wyolum/ArthurC/README.md

ArthurC
=======

rev 2 of i2GPS - called ArthurC in honor of Arthur C Clarke, who coined the idea of GPS
