wyolum/ArthurC/KiCAD/rev2/arthurc_BoM.ods

Sheet: BoM
BoM, for kit building assembly
ref | value | Vendor | Vendor P/N | NOTE 2 | QTY | RATE | AMOUNT
BT1 | BATT_RTC | DigiKey (http://search.digikey.com/us/en/products/BHX1-1632-SM/BHX1-1632-SM-ND/2194759) | BHX1-1632-SM-ND | SMD Battery socket for CR1632 | 1 | 0.44 | 0.44
* | CR1632 | DigiKey (http://search.digikey.com/us/en/products/CR1632/P036-ND/269743) | P036-ND | Battery, CR1632 | 1 | 1.08 | 1.08
C1 | 100n | DigiKey (http://search.digikey.com/us/en/products/GRM216F51C104ZA01D/490-1734-1-ND/587608) | 490-1734-1-ND | Decoupling Capacitor | 1 | 0.05 | 0.05
C2 | 1u | DigiKey (http://search.digikey.com/us/en/products/C2012Y5V1C105Z/0.85/0.85/445-1589-1-ND/603224) | 445-1589-1-ND | Non-electrolytic (Ceramic) | 1 | 0.06 | 0.06
C3 | 2u2 | DigiKey (http://search.digikey.com/us/en/products/F921A225MPA/493-2331-1-ND/677799) | 493-2331-1-ND | Tantalum, Polarized, 10V | 1 | 0.46 | 0.46
C4 | 100n | DigiKey (http://search.digikey.com/us/en/products/GRM216F51C104ZA01D/490-1734-1-ND/587608) | 490-1734-1-ND | Decoupling Capacitor | 1 | 0.05 | 0.05
C5 | 1u | DigiKey (http://search.digikey.com/us/en/products/C2012Y5V1C105Z/0.85/445-1589-1-ND/603224) | 445-1589-1-ND | Non-electrolytic (Ceramic) | 1 | 0.06 | 0.06
C6 | 47u | DigiKey (http://search.digikey.com/us/en/products/EEE-1AA470WR/PCE3875CT-ND/766251) | PCE3875CT-ND | Electrolytic, SMD | 1 | 0.43 | 0.43
C7 | 100n | DigiKey (http://search.digikey.com/us/en/products/GRM216F51C104ZA01D/490-1734-1-ND/587608) | 490-1734-1-ND | Decoupling Capacitor | 1 | 0.05 | 0.05
C8 | 100n | DigiKey (http://search.digikey.com/us/en/products/GRM216F51C104ZA01D/490-1734-1-ND/587608) | 490-1734-1-ND | Decoupling Capacitor | 1 | 0.05 | 0.05
C9 | 100n | DigiKey (http://search.digikey.com/us/en/products/GRM216F51C104ZA01D/490-1734-1-ND/587608) | 490-1734-1-ND | Decoupling Capacitor | 1 | 0.05 | 0.05
C10 | 22p | DigiKey (http://www.digikey.com/product-detail/en/C0805C220J5GACTU/399-1113-1-ND/411388) | 399-1113-1-ND |  | 1 | 0.05 | 0.05
C11 | 22p | DigiKey (http://www.digikey.com/product-detail/en/C0805C220J5GACTU/399-1113-1-ND/411388) | 399-1113-1-ND |  | 1 | 0.05 | 0.05
D1 | LED | DigiKey (http://search.digikey.com/us/en/products/LG%20M67K-H1J2-24-Z/475-2730-1-ND/1938897) | 475-2730-1-ND | LED, Green, 2mA current | 1 | 0.19 | 0.19
D2 | LED | DigiKey (http://search.digikey.com/us/en/products/LG%20M67K-H1J2-24-Z/475-2730-1-ND/1938897) | 475-2730-1-ND | LED, Green, 2mA current | 1 | 0.19 | 0.19
D3 | RB886GT2R | DigiKey (http://search.digikey.com/us/en/products/RB886GT2R/RB886GT2RCT-ND/2425047) | RB886GT2RCT-ND | Schottky Diode, Vf=0.35V | 1 | 0.46 | 0.46
D4 | RB886GT2R | DigiKey (http://search.digikey.com/us/en/products/RB886GT2R/RB886GT2RCT-ND/2425047) | RB886GT2RCT-ND | Schottky Diode, Vf=0.35V | 1 | 0.46 | 0.46
IC1 | ATMEGA328 | Mouser (http://cn.mouser.com/ProductDetail/Atmel/ATMEGA328P-AU/?qs=K8BHR703ZXjB9uTYboq2G8tTH4sPZjy6RRxLXuJxae0=) | 556-ATMEGA328P-AU | Micro-controller | 1 | 2.41 | 2.41
PCB1 | PCB | seeed | PCB, 2.5” x 1.2” | PCB | 1 | 0.00 | 0.00
R1 | 10k | DigiKey (http://search.digikey.com/us/en/products/RR1220P-103-D/RR12P10.0KDCT-ND/432854) | RR12P10.0KDCT-ND |  | 1 | 0.11 | 0.11
R2 | 10k | DigiKey (http://search.digikey.com/us/en/products/RR1220P-103-D/RR12P10.0KDCT-ND/432854) | RR12P10.0KDCT-ND |  | 1 | 0.11 | 0.11
R3 | 10k | DigiKey (http://search.digikey.com/us/en/products/RR1220P-103-D/RR12P10.0KDCT-ND/432854) | RR12P10.0KDCT-ND |  | 1 | 0.11 | 0.11
R4 | 10k | DigiKey (http://search.digikey.com/us/en/products/RR1220P-103-D/RR12P10.0KDCT-ND/432854) | RR12P10.0KDCT-ND |  | 1 | 0.11 | 0.11
R5 | 1k5 | DigiKey (http://search.digikey.com/us/en/products/RR1220P-152-D/RR12P1.5KDCT-ND/432834) | RR12P1.5KDCT-ND |  | 1 | 0.11 | 0.11
R6 | 10k | DigiKey (http://search.digikey.com/us/en/products/RR1220P-103-D/RR12P10.0KDCT-ND/432854) | RR12P10.0KDCT-ND |  | 1 | 0.11 | 0.11
R7 | 10k | DigiKey (http://search.digikey.com/us/en/products/RR1220P-103-D/RR12P10.0KDCT-ND/432854) | RR12P10.0KDCT-ND |  | 1 | 0.11 | 0.11
R8 | 1k5 | DigiKey (http://search.digikey.com/us/en/products/RR1220P-152-D/RR12P1.5KDCT-ND/432834) | RR12P1.5KDCT-ND |  | 1 | 0.11 | 0.11
R9 | 10k | DigiKey (http://search.digikey.com/us/en/products/RR1220P-103-D/RR12P10.0KDCT-ND/432854) | RR12P10.0KDCT-ND |  | 1 | 0.11 | 0.11
SD1 | SD_CARD_MICRO | DigiKey (http://search.digikey.com/us/en/products/101-00434-68/101-00434-68-1-ND/2187103) | 101-00434-68-1-ND | CONN SIM+MICRO-SD 14PIN PCB GOLD | 1 | 3.06 | 3.06
SW1 | SW_PUSH | DigiKey (http://search.digikey.com/us/en/products/EVQ-P2602W/P12301SCT-ND/593601) | P12301SCT-ND | Reset Switch | 1 | 0.83 | 0.83
U1 | 3V3 | DigiKey (http://goo.gl/aD8x4) | MCP1700T3302ETTCT-ND | 3.3V Regulator, MCP1700T-3302E/TT | 1 | 0.45 | 0.45
U2 | 74HC125 | DigiKey (http://search.digikey.com/us/en/products/MC74HC125ADG/MC74HC125ADGOS-ND/1479839) | MC74HC125ADGOS-ND | Alternative P/N – 296-1192-1-ND | 1 | 0.44 | 0.44
U3 | 5V0 | DigiKey (http://search.digikey.com/us/en/products/MIC5219-5.0YM5%20TR/576-2770-1-ND/1821930) | 576-2770-1-ND | 5.0V Regulator, MIC5219-5.0BM5 | 1 | 1.43 | 1.43
U4 | DS3231N | DigiKey (http://goo.gl/gg9GS) | DS3231S#-ND | RTC | 1 | 7.94 | 7.94
X1 | CRYSTAL_2 | DigiKey (http://search.digikey.com/us/en/products/CX3225GB16000D0HEQZ1/478-6622-1-ND/2665884) | 478-6622-1-ND | 16MHz Crystal, SMD | 1 | 1.30 | 1.30
 |  |  |  |  | 35 | 23.00 | 23.00
NOT USED COMPONENTS
B1 | I/O |  |  | break out pads | 1 | 0.00 | 0.00
B2 | I/O |  |  | break out pads | 1 | 0.00 | 0.00
B3 | I/O |  |  | break out pads | 1 | 0.00 | 0.00
B4 | I/O |  |  | break out pads | 1 | 0.00 | 0.00
B5 | I/O |  |  | break out pads | 1 | 0.00 | 0.00
B6 | I/O |  |  | break out pads | 1 | 0.00 | 0.00
B7 | I/O |  |  | break out pads | 1 | 0.00 | 0.00
B8 | I/O |  |  | break out pads | 1 | 0.00 | 0.00
B9 | I/O |  |  | break out pads | 1 | 0.00 | 0.00
B10 | I/O |  |  | break out pads | 1 | 0.00 | 0.00
B11 | I/O |  |  | break out pads | 1 | 0.00 | 0.00
B12 | I/O |  |  | break out pads | 1 | 0.00 | 0.00
B13 | I/O |  |  | break out pads | 1 | 0.00 | 0.00
B14 | I/O |  |  | break out pads | 1 | 0.00 | 0.00
B15 | I/O |  |  | break out pads | 1 | 0.00 | 0.00
B16 | I/O |  |  | break out pads | 1 | 0.00 | 0.00
B17 | I/O |  |  | break out pads | 1 | 0.00 | 0.00
B18 | I/O |  |  | break out pads | 1 | 0.00 | 0.00
B19 | I/O |  |  | break out pads | 1 | 0.00 | 0.00
P1 | I/O |  |  | break out pads | 1 | 0.00 | 0.00
P3 | BootDrive | DigiKey (http://search.digikey.com/us/en/products/68000-236HLF/609-3465-ND/2023290) | 475-2555-1-ND | Header for BootDrive | 1 | 0.18 | 0.18
P4 | CONN_6 | DigiKey (http://search.digikey.com/us/en/products/68000-236HLF/609-3465-ND/2023290) | 475-2555-1-ND | Buckler Interface | 1 | 0.18 | 0.18
P5 | CONN_6 | DigiKey (http://search.digikey.com/us/en/products/68000-236HLF/609-3465-ND/2023290) | 475-2555-1-ND | Buckler Interface | 1 | 0.18 | 0.18
P6 | CONN_2 | DigiKey (http://search.digikey.com/us/en/products/68000-236HLF/609-3465-ND/2023290) | 475-2555-1-ND | Ext. 9V Battery | 1 | 0.06 | 0.06
P7 | GPS_UP501 | DigiKey (http://search.digikey.com/us/en/products/68000-236HLF/609-3465-ND/2023290) | 475-2555-1-ND | GPS Header | 1 | 0.18 | 0.18
P8 | FTDI | DigiKey (http://search.digikey.com/us/en/products/68000-236HLF/609-3465-ND/2023290) | 475-2555-1-ND | FTDI <>USB Interface | 1 | 0.18 | 0.18
P9 | ISP | DigiKey (http://search.digikey.com/us/en/products/67996-130HLF/609-3456-ND/2023300) | 609-3456-ND | ISP Programming Interface | 1 | 0.37 | 0.37
P10 | CD2 | DigiKey (http://search.digikey.com/scripts/DkSearch/dksus.dll?vendor=0&keywords=S5635-ND) | S5635-ND | ChronoDot/rtcBoB connections | 1 | 0.92 | 0.92
P11 | CD2 | DigiKey (http://search.digikey.com/scripts/DkSearch/dksus.dll?vendor=0&keywords=S5635-ND) | S5635-ND | either P10+P12 or P11+P13 | 1 | 0.92 | 0.92
P12 | CD1 | DigiKey (http://search.digikey.com/scripts/DkSearch/dksus.dll?vendor=0&keywords=S5635-ND) | S5635-ND | ChronoDot/rtcBoB connections | 1 | 0.92 | 0.92
P13 | CD1 | DigiKey (http://search.digikey.com/scripts/DkSearch/dksus.dll?vendor=0&keywords=S5635-ND) | S5635-ND | either P10+P12 or P11+P13 | 1 | 0.92 | 0.92
SC1 | SCREW |  |  | Mounting Hole | 1 | 0.00 | 0.00
 |  |  |  |  | 32 | 4.98 | 4.98
MISC. COMPONENTS
 | SD_CARD |  | http://www.te.com/catalog/bin/TE.Connect?C=1&M=BYPN&TCPN=2041021-3&RQPN=2041021-3
 | 35R2925 |  | http://www.newark.com/te-connectivity/2041021-3/memory-card-connector-sd-9pos/dp/35R2925?CMP=AFC-HEARST
 | A101492CT-ND |  | http://search.digikey.com/scripts/DkSearch/dksus.dll?Detail&name=A101492CT-ND
 |  |  |  |  | 0 | 0.00 | 0.00
 |  |  |  |  |  |  | 23.00

Sheet: BoM_PCB
Id | Designator | Package | Quantity | Designation | Supplier and ref
1 | B1,B2,B3,B4,B5,B6,B7,B8,B9,B12,B13,B14,B15,B18,B19,P1, | I/O | 16 | I/O
2 | B10,B11,B16,B17 | I/O_ADR | 4 | I/O
3 | BT1 | CR1632 | 1 | BATT_RTC
4 | C1,C4,C7,C8,C9 | c_0805 | 5 | 100n
5 | C10,C11 | c_0805 | 2 | 22p
6 | C2,C5 | c_0805 | 2 | 1u
7 | C3 | c_0805 | 1 | 2u2_Tant
8 | C6 | C_ELCO_SMD | 1 | 47u,10V
9 | D1,D2 | d_0805 | 2 | LED
10 | D3,D4 | d_VMD2 | 2 | RB886GT2R
11 | G*** | OSHW_6mm | 1 | LOGO
12 | G1,G1 | Logo-WL3 | 2 | Logo-WL3
13 | IC1 | TQFP32 | 1 | ATMEGA328
14 | P10,P11 | Sck-04-F-SMT | 2 | CD2
15 | P12,P13 | Sck-04-F-SMT | 2 | CD1
16 | P3 | PIN_ARRAY-6X1 | 1 | BootDrive
17 | P4,P5 | PIN_ARRAY-6X1 | 2 | CONN_6
18 | P6 | pin_strip_2 | 1 | CONN_2
19 | P7 | PIN_ARRAY-6X1 | 1 | GPS_UP501
20 | P8 | PIN_ARRAY-6X1 | 1 | FTDI
21 | P9 | ISP | 1 | ISP
22 | PCB1 | PCB | 1 | PCB
23 | R1,R2,R3,R4,R6,R7,R9 | r_0805 | 7 | 10k
24 | R5,R8 | r_0805 | 2 | 1k5
25 | SC1 | vite_3mm | 1 | SCREW
26 | SD1 | SD_Micro | 1 | SD_CARD_MICRO
27 | SW1 | SW_SMD | 1 | SW_PUSH
28 | U1 | SOT23-3 | 1 | 3V3
29 | U2 | SO14E | 1 | 74HC125
30 | U3 | SOT23-5 | 1 | 5V0
31 | U4 | DS3231 | 1 | DS3231N
32 | X1 | Xtal_SMD2 | 1 | CRYSTAL_2
 |  |  | 69

Sheet: BoM_SCH
ref | value | footprint | Field1 | Field2 | Field3 | Field4 | Field5 | Field6 | Field7 | Field8
B1 | I/O | I/O
B2 | I/O | I/O
B3 | I/O | I/O
B4 | I/O | I/O
B5 | I/O | I/O
B6 | I/O | I/O
B7 | I/O | I/O
B8 | I/O | I/O
B9 | I/O | I/O
B10 | I/O | I/O_ADR
B11 | I/O | I/O_ADR
B12 | I/O | I/O
B13 | I/O | I/O
B14 | I/O | I/O
B15 | I/O | I/O
B16 | I/O | I/O_ADR
B17 | I/O | I/O_ADR
B18 | I/O | I/O
B19 | I/O | I/O
BT1 | BATT_RTC | CR1632 | BU2032SM-HD-GCT-ND |  |  |  |  |  |  |  | BU2032SM-HD-GCT-ND
C1 | 100n | c_0805
C2 | 1u | c_0805
C3 | 2u2 | Tant | c_0805 |  |  |  |  |  |  |  | c_0805
C4 | 100n | c_0805
C5 | 1u | c_0805
C6 | 47u | 10V | C_ELCO_SMD |  |  |  |  |  |  |  | C_ELCO_SMD
C7 | 100n | c_0805
C8 | 100n | c_0805
C9 | 100n | c_0805
C10 | 22p | c_0805 | 490-1734-1-ND |  |  |  |  |  |  |  | 490-1734-1-ND
C11 | 22p | c_0805 | 490-1734-1-ND |  |  |  |  |  |  |  | 490-1734-1-ND
D1 | LED | d_0805
D2 | LED | d_0805
D3 | RB886GT2R | d_VMD2
D4 | RB886GT2R | d_VMD2
IC1 | ATMEGA328 | TQFP32
P1 | I/O | I/O
P3 | BootDrive | PIN_ARRAY-6X1
P4 | CONN_6 | PIN_ARRAY-6X1
P5 | CONN_6 | PIN_ARRAY-6X1
P6 | CONN_2 | pin_strip_2
P7 | GPS_UP501 | PIN_ARRAY-6X1
P8 | FTDI | PIN_ARRAY-6X1
P9 | ISP | ISP
P10 | CD2 | Sck-04-F-SMT
P11 | CD2 | Sck-04-F-SMT
P12 | CD1 | Sck-04-F-SMT
P13 | CD1 | Sck-04-F-SMT
PCB1 | PCB | PCB
R1 | 10k | r_0805
R2 | 10k | r_0805
R3 | 10k | r_0805
R4 | 10k | r_0805
R5 | 1k5 | r_0805
R6 | 10k | r_0805
R7 | 10k | r_0805
R8 | 1k5 | r_0805
R9 | 10k | r_0805
SC1 | SCREW | vite_3mm
SD1 | SD_CARD_MICRO | SD_Micro
SW1 | SW_PUSH | SW_SMD
U1 | 3V3 | SOT23-3 | MCP1700T-3302E/TT
U2 | 74HC125 | SO14E
U3 | 5V0 | SOT23-5 | MIC5219-5.0BM5
U4 | DS3231N | DS3231
X1 | CRYSTAL_2 | Xtal_SMD2
