wyolum/ArthurC/KiCAD/rev2/arthurc_BoM_seeed.ods

BoM, for kit building assembly
ref | value | Position X | Position Y | Orientation | Layer | Vendor | Vendor P/N | NOTE 2 | QTY
BT1 | BATT_RTC | 2.6625 | 1.5350 | 180 | Back | DigiKey (http://search.digikey.com/us/en/products/BHX1-1632-SM/BHX1-1632-SM-ND/2194759) | BHX1-1632-SM-ND | SMD Battery socket for CR1632 | 1
* | CR1632 | -- | -- | -- | -- | DigiKey (http://search.digikey.com/us/en/products/CR1632/P036-ND/269743) | P036-ND | Battery, CR1632 | 1
C1 | 100n | 1.7825 | 1.6525 | 270 | Front | DigiKey (http://search.digikey.com/us/en/products/GRM216F51C104ZA01D/490-1734-1-ND/587608) | 490-1734-1-ND | Decoupling Capacitor | 1
C2 | 1u | 2.5050 | 1.4000 | 270 | Front | DigiKey (http://search.digikey.com/us/en/products/C2012Y5V1C105Z/0.85/0.85/445-1589-1-ND/603224) | 445-1589-1-ND | Non-electrolytic (Ceramic) | 1
C3 | 2u2 | 3.0675 | 1.0975 | 0 | Front | DigiKey (http://search.digikey.com/us/en/products/F921A225MPA/493-2331-1-ND/677799) | 493-2331-1-ND | Tantalum, Polarized, 10V | 1
C4 | 100n | 2.9025 | 1.0975 | 180 | Front | DigiKey (http://search.digikey.com/us/en/products/GRM216F51C104ZA01D/490-1734-1-ND/587608) | 490-1734-1-ND | Decoupling Capacitor | 1
C5 | 1u | 2.6450 | 1.3700 | 180 | Front | DigiKey (http://search.digikey.com/us/en/products/C2012Y5V1C105Z/0.85/445-1589-1-ND/603224) | 445-1589-1-ND | Non-electrolytic (Ceramic) | 1
C6 | 47u | 2.8925 | 1.5400 | 90 | Front | DigiKey (http://search.digikey.com/us/en/products/EEE-1AA470WR/PCE3875CT-ND/766251) | PCE3875CT-ND | Electrolytic, SMD | 1
C7 | 100n | 2.6400 | 1.6750 | 0 | Front | DigiKey (http://search.digikey.com/us/en/products/GRM216F51C104ZA01D/490-1734-1-ND/587608) | 490-1734-1-ND | Decoupling Capacitor | 1
C8 | 100n | 2.9100 | 1.3675 | 0 | Front | DigiKey (http://search.digikey.com/us/en/products/GRM216F51C104ZA01D/490-1734-1-ND/587608) | 490-1734-1-ND | Decoupling Capacitor | 1
C9 | 100n | 1.5575 | 1.3200 | 0 | Back | DigiKey (http://search.digikey.com/us/en/products/GRM216F51C104ZA01D/490-1734-1-ND/587608) | 490-1734-1-ND | Decoupling Capacitor | 1
C10 | 22p | 2.3775 | 1.1350 | 270 | Front | DigiKey (http://www.digikey.com/product-detail/en/C0805C220J5GACTU/399-1113-1-ND/411388) | 399-1113-1-ND |  | 1
C11 | 22p | 2.2725 | 1.1350 | 90 | Front | DigiKey (http://www.digikey.com/product-detail/en/C0805C220J5GACTU/399-1113-1-ND/411388) | 399-1113-1-ND |  | 1
D1 | LED | 2.5375 | 1.0975 | 0 | Front | DigiKey (http://search.digikey.com/us/en/products/LG%20M67K-H1J2-24-Z/475-2730-1-ND/1938897) | 475-2730-1-ND | LED, Green, 2mA current | 1
D2 | LED | 2.7000 | 1.0975 | 0 | Front | DigiKey (http://search.digikey.com/us/en/products/LG%20M67K-H1J2-24-Z/475-2730-1-ND/1938897) | 475-2730-1-ND | LED, Green, 2mA current | 1
D3 | RB886GT2R | 3.3020 | 1.3500 | 270 | Front | DigiKey (http://search.digikey.com/us/en/products/RB886GT2R/RB886GT2RCT-ND/2425047) | RB886GT2RCT-ND | Schottky Diode, Vf=0.35V | 1
D4 | RB886GT2R | 3.2360 | 1.3500 | 270 | Front | DigiKey (http://search.digikey.com/us/en/products/RB886GT2R/RB886GT2RCT-ND/2425047) | RB886GT2RCT-ND | Schottky Diode, Vf=0.35V | 1
IC1 | ATMEGA328 | 2.2525 | 1.6350 | 270 | Front | Mouser (http://cn.mouser.com/ProductDetail/Atmel/ATMEGA328P-AU/?qs=K8BHR703ZXjB9uTYboq2G8tTH4sPZjy6RRxLXuJxae0=) | 556-ATMEGA328P-AU | Micro-controller | 1
PCB1 | PCB |  |  |  |  | seeed | PCB, 2.5” x 1.2” | PCB | 1
R1 | 10k | 3.1325 | 1.9350 | 90 | Front | DigiKey (http://search.digikey.com/us/en/products/RR1220P-103-D/RR12P10.0KDCT-ND/432854) | RR12P10.0KDCT-ND |  | 1
R2 | 10k | 3.0275 | 1.9350 | 90 | Front | DigiKey (http://search.digikey.com/us/en/products/RR1220P-103-D/RR12P10.0KDCT-ND/432854) | RR12P10.0KDCT-ND |  | 1
R3 | 10k | 1.5325 | 1.1950 | 270 | Front | DigiKey (http://search.digikey.com/us/en/products/RR1220P-103-D/RR12P10.0KDCT-ND/432854) | RR12P10.0KDCT-ND |  | 1
R4 | 10k | 1.5325 | 1.3525 | 90 | Front | DigiKey (http://search.digikey.com/us/en/products/RR1220P-103-D/RR12P10.0KDCT-ND/432854) | RR12P10.0KDCT-ND |  | 1
R5 | 1k5 | 2.5375 | 1.1925 | 180 | Front | DigiKey (http://search.digikey.com/us/en/products/RR1220P-152-D/RR12P1.5KDCT-ND/432834) | RR12P1.5KDCT-ND |  | 1
R6 | 10k | 1.6325 | 1.3525 | 90 | Front | DigiKey (http://search.digikey.com/us/en/products/RR1220P-103-D/RR12P10.0KDCT-ND/432854) | RR12P10.0KDCT-ND |  | 1
R7 | 10k | 2.6400 | 1.7750 | 0 | Front | DigiKey (http://search.digikey.com/us/en/products/RR1220P-103-D/RR12P10.0KDCT-ND/432854) | RR12P10.0KDCT-ND |  | 1
R8 | 1k5 | 2.7000 | 1.1925 | 180 | Front | DigiKey (http://search.digikey.com/us/en/products/RR1220P-152-D/RR12P1.5KDCT-ND/432834) | RR12P1.5KDCT-ND |  | 1
R9 | 10k | 1.8400 | 1.8325 | 90 | Back | DigiKey (http://search.digikey.com/us/en/products/RR1220P-103-D/RR12P10.0KDCT-ND/432854) | RR12P10.0KDCT-ND |  | 1
SD1 | SD_CARD_MICRO | 1.2625 | 1.5350 | 270 | Front | DigiKey (http://search.digikey.com/us/en/products/101-00434-68/101-00434-68-1-ND/2187103) | 101-00434-68-1-ND | CONN SIM+MICRO-SD 14PIN PCB GOLD | 1
SW1 | SW_PUSH | 1.8400 | 1.9725 | 180 | Front | DigiKey (http://search.digikey.com/us/en/products/EVQ-P2602W/P12301SCT-ND/593601) | P12301SCT-ND | Reset Switch | 1
U1 | 3V3 | 2.6450 | 1.5300 | 180 | Front | DigiKey (http://goo.gl/aD8x4) | MCP1700T3302ETTCT-ND | 3.3V Regulator, MCP1700T-3302E/TT | 1
U2 | 74HC125 | 1.2825 | 1.2500 | 0 | Front | DigiKey (http://search.digikey.com/us/en/products/MC74HC125ADG/MC74HC125ADGOS-ND/1479839) | MC74HC125ADGOS-ND | Alternative P/N – 296-1192-1-ND | 1
U3 | 5V0 | 2.9050 | 1.2350 | 90 | Front | DigiKey (http://search.digikey.com/us/en/products/MIC5219-5.0YM5%20TR/576-2770-1-ND/1821930) | 576-2770-1-ND | 5.0V Regulator, MIC5219-5.0BM5 | 1
U4 | DS3231N | 1.5725 | 1.6075 | 180 | Back | DigiKey (http://goo.gl/gg9GS) | DS3231S#-ND | RTC | 1
X1 | CRYSTAL_2 | 2.2025 | 1.2825 | 180 | Front | DigiKey (http://search.digikey.com/us/en/products/CX3225GB16000D0HEQZ1/478-6622-1-ND/2665884) | 478-6622-1-ND | 16MHz Crystal, SMD | 1
 |  |  |  |  |  |  |  |  | 35
NOT USED COMPONENTS
B1 | I/O |  |  |  |  |  |  | break out pads | 1
B2 | I/O |  |  |  |  |  |  | break out pads | 1
B3 | I/O |  |  |  |  |  |  | break out pads | 1
B4 | I/O |  |  |  |  |  |  | break out pads | 1
B5 | I/O |  |  |  |  |  |  | break out pads | 1
B6 | I/O |  |  |  |  |  |  | break out pads | 1
B7 | I/O |  |  |  |  |  |  | break out pads | 1
B8 | I/O |  |  |  |  |  |  | break out pads | 1
B9 | I/O |  |  |  |  |  |  | break out pads | 1
B10 | I/O |  |  |  |  |  |  | break out pads | 1
B11 | I/O |  |  |  |  |  |  | break out pads | 1
B12 | I/O |  |  |  |  |  |  | break out pads | 1
B13 | I/O |  |  |  |  |  |  | break out pads | 1
B14 | I/O |  |  |  |  |  |  | break out pads | 1
B15 | I/O |  |  |  |  |  |  | break out pads | 1
B16 | I/O |  |  |  |  |  |  | break out pads | 1
B17 | I/O |  |  |  |  |  |  | break out pads | 1
B18 | I/O |  |  |  |  |  |  | break out pads | 1
B19 | I/O |  |  |  |  |  |  | break out pads | 1
P1 | I/O |  |  |  |  |  |  | break out pads | 1
P3 | BootDrive | 3.3900 | 1.9000 | 90 | Front | DigiKey (http://search.digikey.com/us/en/products/68000-236HLF/609-3465-ND/2023290) | 475-2555-1-ND | Header for BootDrive | 1
P4 | CONN_6 | 2.2825 | 2.1100 | 0 | Front | DigiKey (http://search.digikey.com/us/en/products/68000-236HLF/609-3465-ND/2023290) | 475-2555-1-ND | Buckler Interface | 1
P5 | CONN_6 | 2.9825 | 2.1100 | 0 | Front | DigiKey (http://search.digikey.com/us/en/products/68000-236HLF/609-3465-ND/2023290) | 475-2555-1-ND | Buckler Interface | 1
P6 | CONN_2 | 3.1125 | 1.2600 | 270 | Front | DigiKey (http://search.digikey.com/us/en/products/68000-236HLF/609-3465-ND/2023290) | 475-2555-1-ND | Ext. 9V Battery | 1
P7 | GPS_UP501 | 3.3900 | 1.3000 | 270 | Front | DigiKey (http://search.digikey.com/us/en/products/68000-236HLF/609-3465-ND/2023290) | 475-2555-1-ND | GPS Header | 1
P8 | FTDI | 3.2325 | 1.7100 | 90 | Front | DigiKey (http://search.digikey.com/us/en/products/68000-236HLF/609-3465-ND/2023290) | 475-2555-1-ND | FTDI <>USB Interface | 1
P9 | ISP | 1.8675 | 1.1800 | 0 | Front | DigiKey (http://search.digikey.com/us/en/products/67996-130HLF/609-3456-ND/2023300) | 609-3456-ND | ISP Programming Interface | 1
P10 | CD2 | 1.5950 | 1.1500 | 0 | Back | DigiKey (http://search.digikey.com/scripts/DkSearch/dksus.dll?vendor=0&keywords=S5635-ND) | S5635-ND | ChronoDot/rtcBoB connections | 1
P11 | CD2 | 1.1450 | 1.6000 | 90 | Back | DigiKey (http://search.digikey.com/scripts/DkSearch/dksus.dll?vendor=0&keywords=S5635-ND) | S5635-ND | either P10+P12 or P11+P13 | 1
P12 | CD1 | 1.5950 | 2.0500 | 0 | Back | DigiKey (http://search.digikey.com/scripts/DkSearch/dksus.dll?vendor=0&keywords=S5635-ND) | S5635-ND | ChronoDot/rtcBoB connections | 1
P13 | CD1 | 2.0450 | 1.6000 | 90 | Back | DigiKey (http://search.digikey.com/scripts/DkSearch/dksus.dll?vendor=0&keywords=S5635-ND) | S5635-ND | either P10+P12 or P11+P13 | 1
SC1 | SCREW |  |  |  |  |  |  | Mounting Hole | 1
 |  |  |  |  |  |  |  |  | 32
MISC. COMPONENTS
 | SD_CARD | 2041021-3 |  | Tyco-TE Connectivity |  |  | http://www.te.com/catalog/bin/TE.Connect?C=1&M=BYPN&TCPN=2041021-3&RQPN=2041021-3
 | 35R2925 | Newark element 14 online |  |  |  |  | http://www.newark.com/te-connectivity/2041021-3/memory-card-connector-sd-9pos/dp/35R2925?CMP=AFC-HEARST
 | A101492CT-ND | Digikey |  |  |  |  | http://search.digikey.com/scripts/DkSearch/dksus.dll?Detail&name=A101492CT-ND
 |  |  |  |  |  |  |  |  | 0
