wyolum/ArthurC/KiCAD/rev2/arthurc.pdf

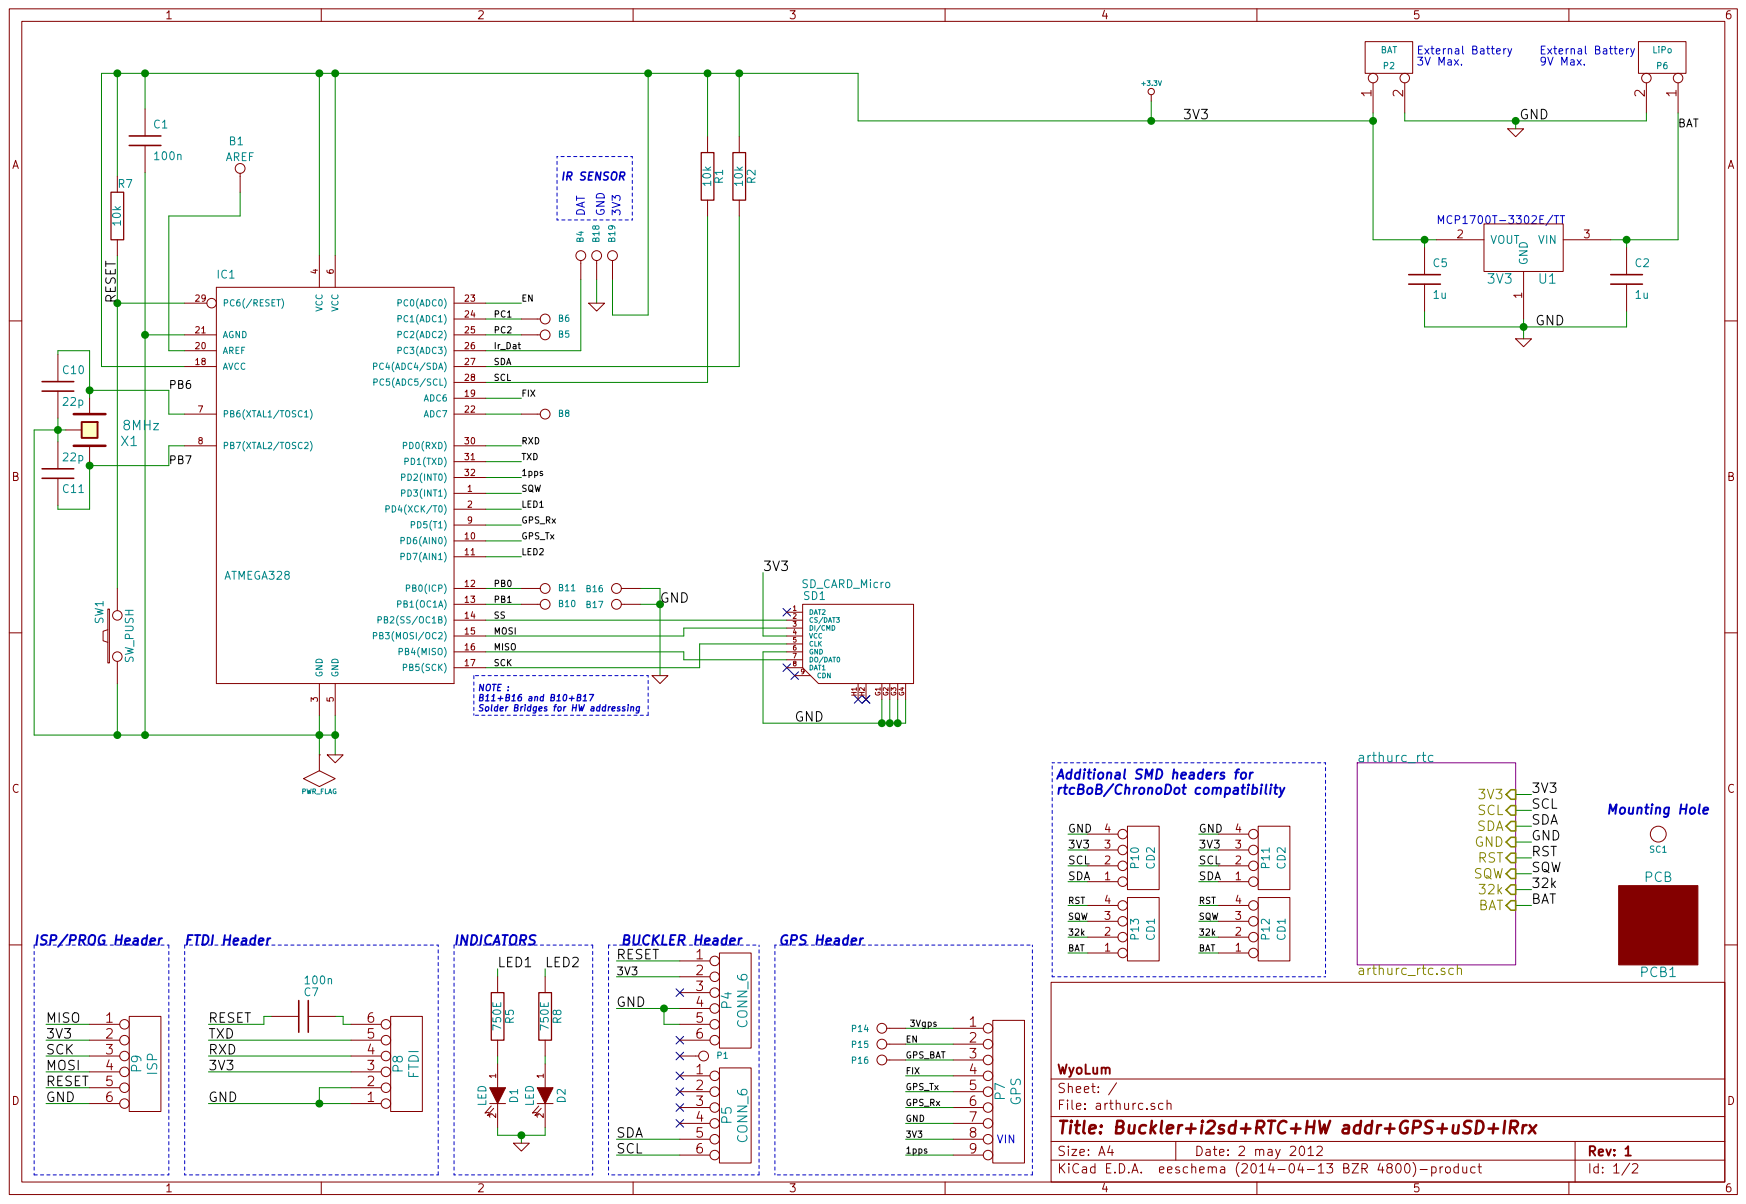
[picture p2: page 1]

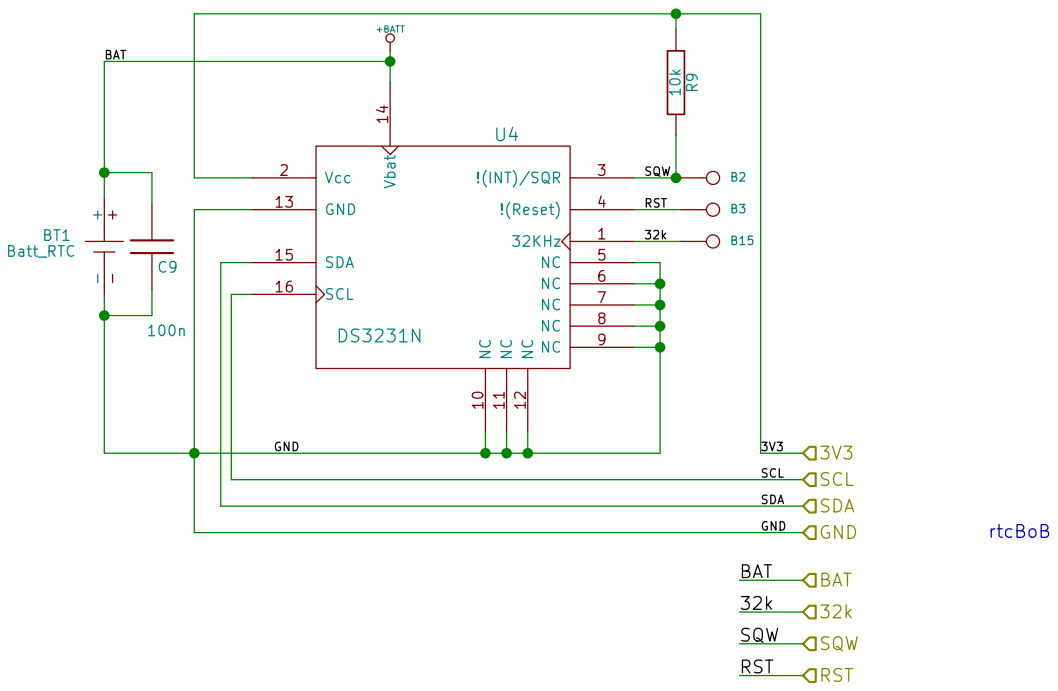
[picture p3: page 2]
