wyolum/ArthurC/KiCAD/rev1/arthurc.pdf

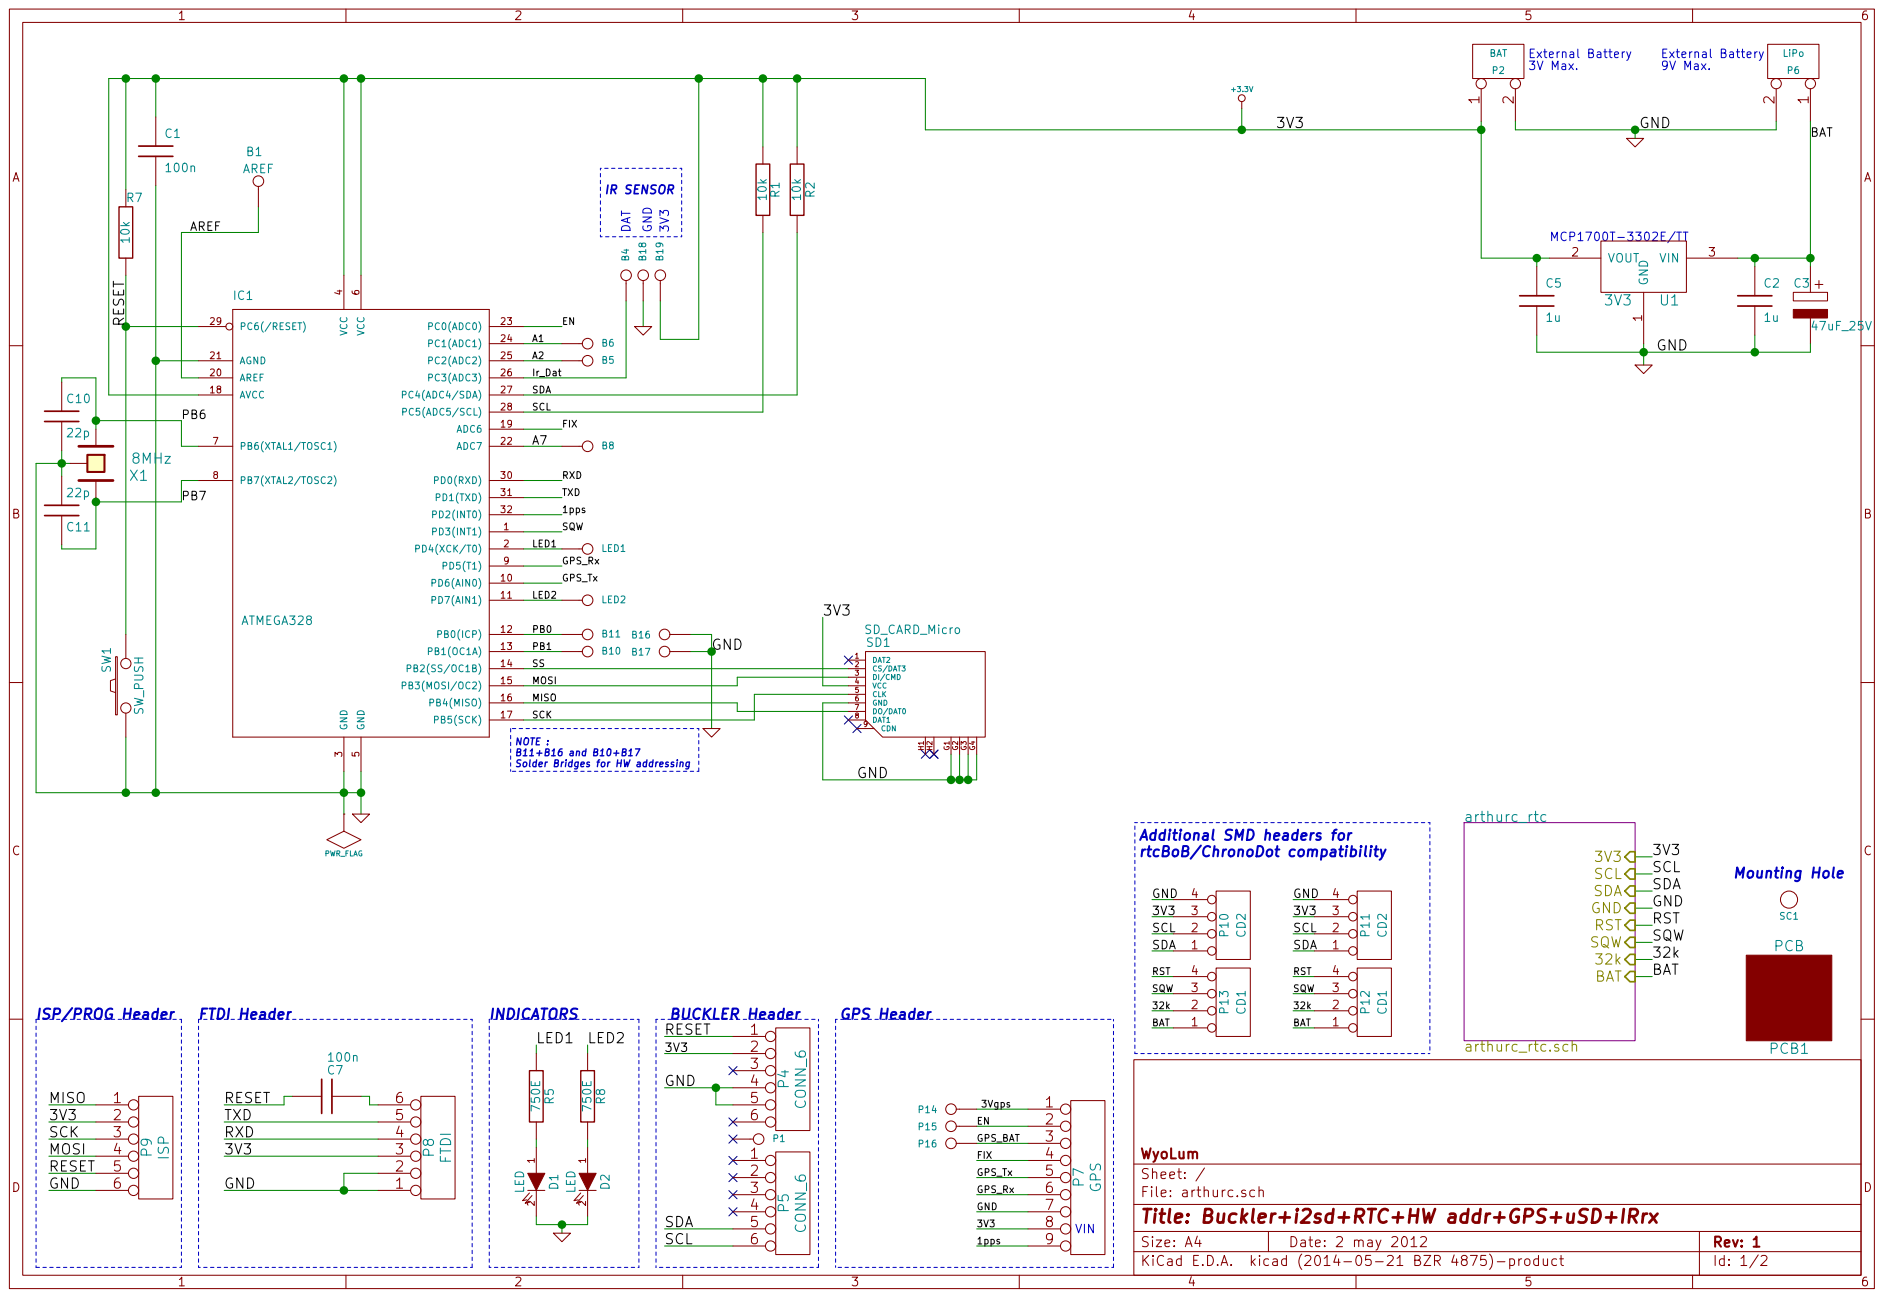
[picture p4: page 1]

6 PB6(XTAL1/TOSC1) 7 PB7(XTAL2/TOSC2) 8 PD5(T1) 9 PD6(AIN0) 10 AREF 20 PD0(RXD) 30 PD7(AIN1) 11 AGND 21 PD1(TXD) 31 PB0(ICP) 12 ADC7 22 PD2(INT0) 32 PB1(OC1A) 13 PC0(ADC0) 23 PB2(SS/OC1B) 14 PC1(ADC1) 24 PB3(MOSI/OC2) 15 PC2(ADC2) 25 PB4(MISO) 16 PC3(ADC3) 26 PB5(SCK) 17 PC4(ADC4/SDA) 27 AVCC 18 PC5(ADC5/SCL) 28 ADC6 19 PC6(/RESET) 29

Additional SMD headers for
rtcBoB/ChronoDot compatibility

File: arthurc.sch Sheet: / WyoLum

Id: 1/2 Title: Buckler+i2sd+RTC+HW addr+GPS+uSD+IRrx

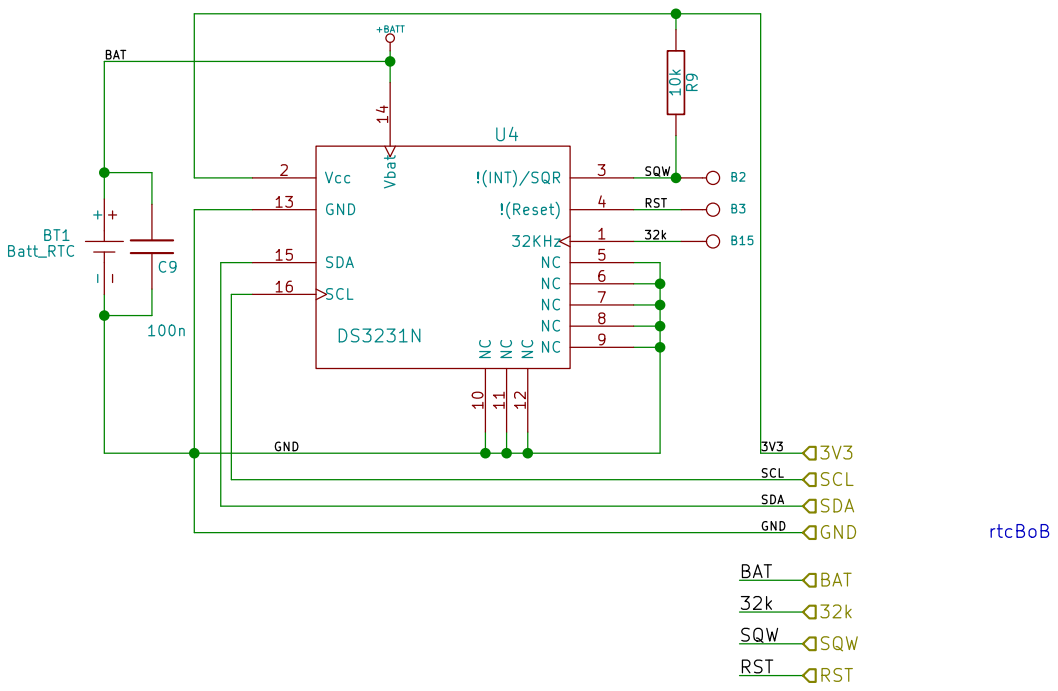
[picture p5: page 2]

WyoLum
Sheet: /arthurc_rtc/
File: arthurc_rtc.sch
Id: 2/2 Title: Buckler, i2sd, v3, with RTC, with HW addressing
