wyolum/ArthurC/KiCAD/rev1/arthurc_pcb.pdf

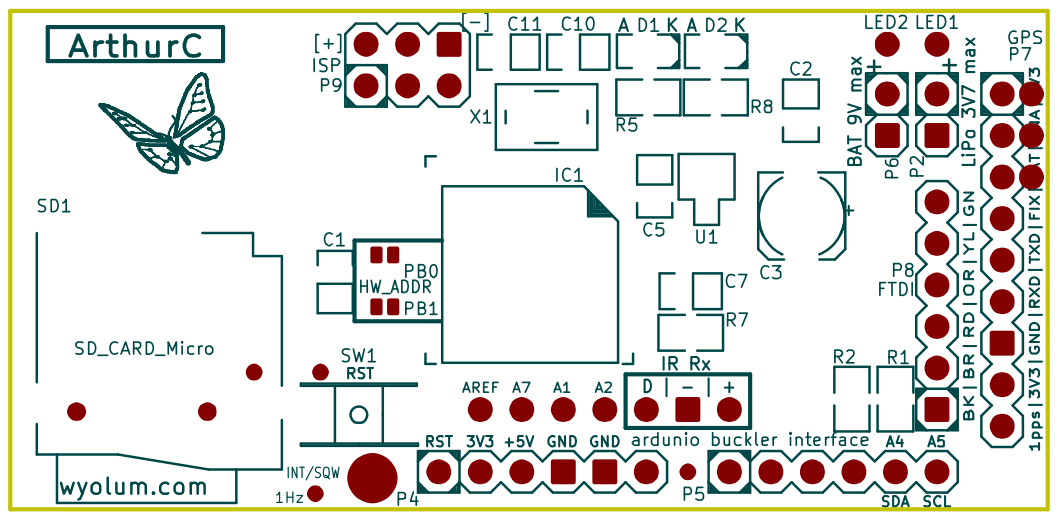
[picture p6: page 1]

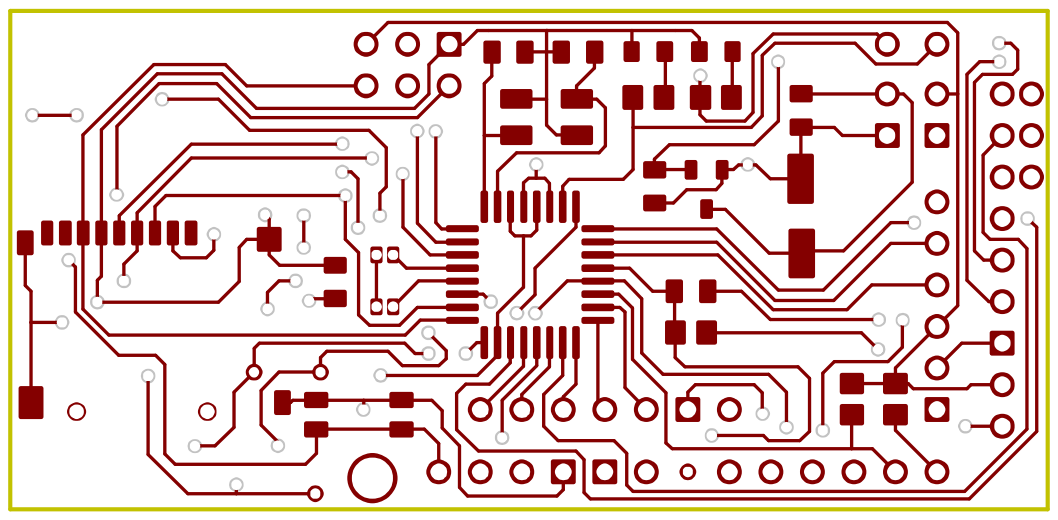
[picture p7: page 2]

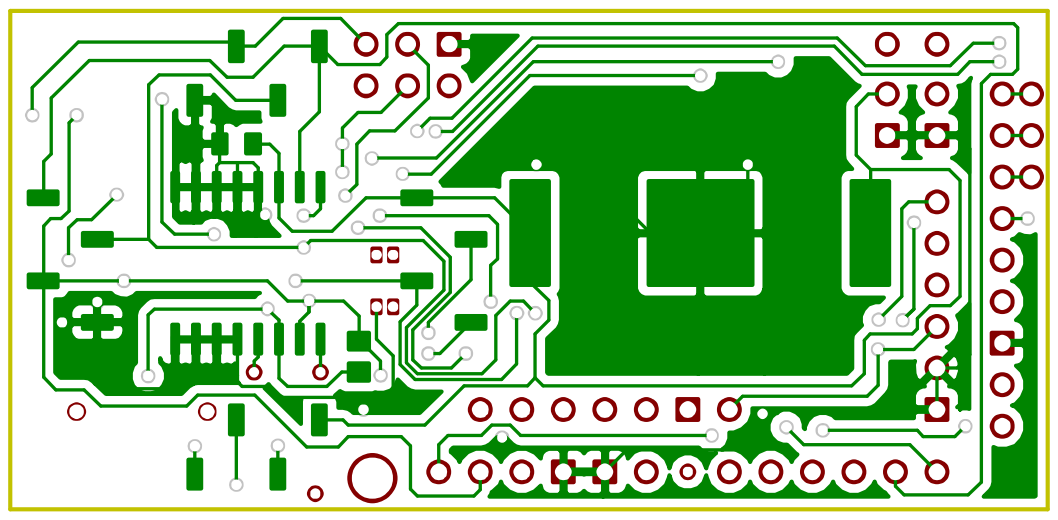
[picture p8: page 3]

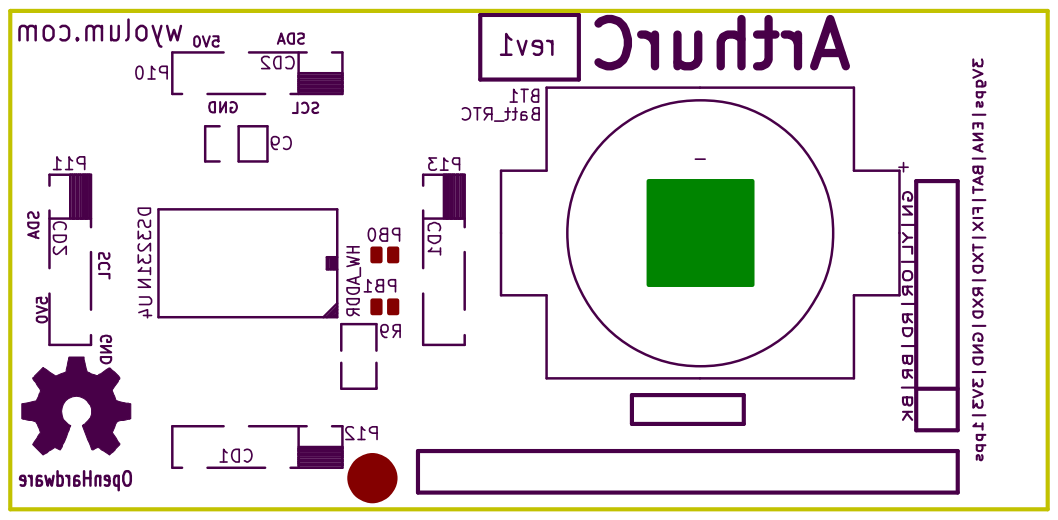
[picture p9: page 4]

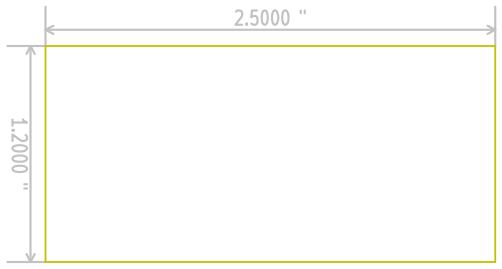
[picture p10: figure]
