wyolum/ArthurC/KiCAD/rev1/arthurc_pcb_1.pdf

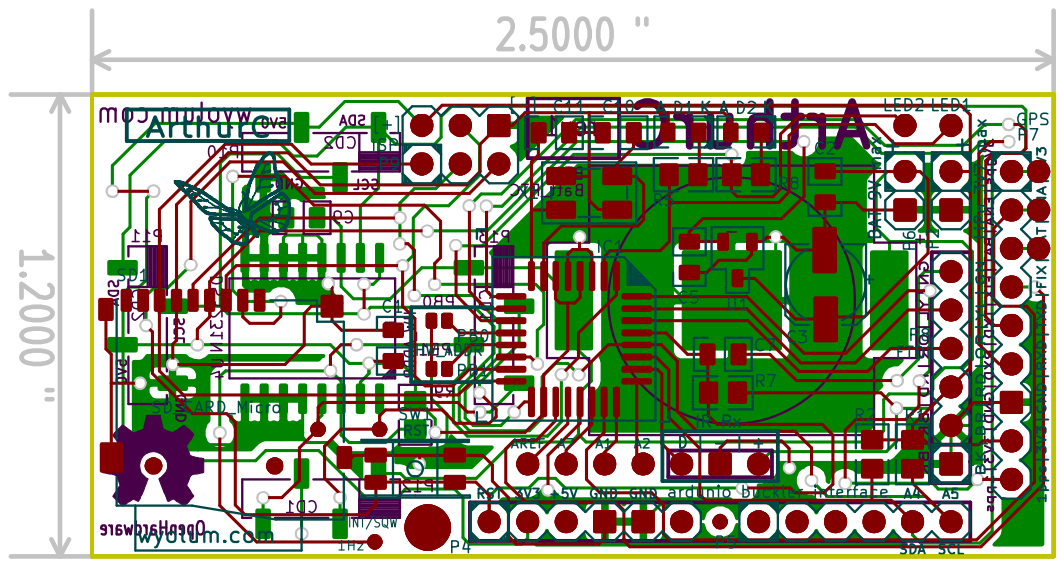
[picture p11: page 1]
