wyolum/ArthurC/KiCAD/rev1/arthurc.kicad_pcb

## KiCad design KiCAD/rev1/arthurc.kicad_pcb (2014-06-26, an earlier design)

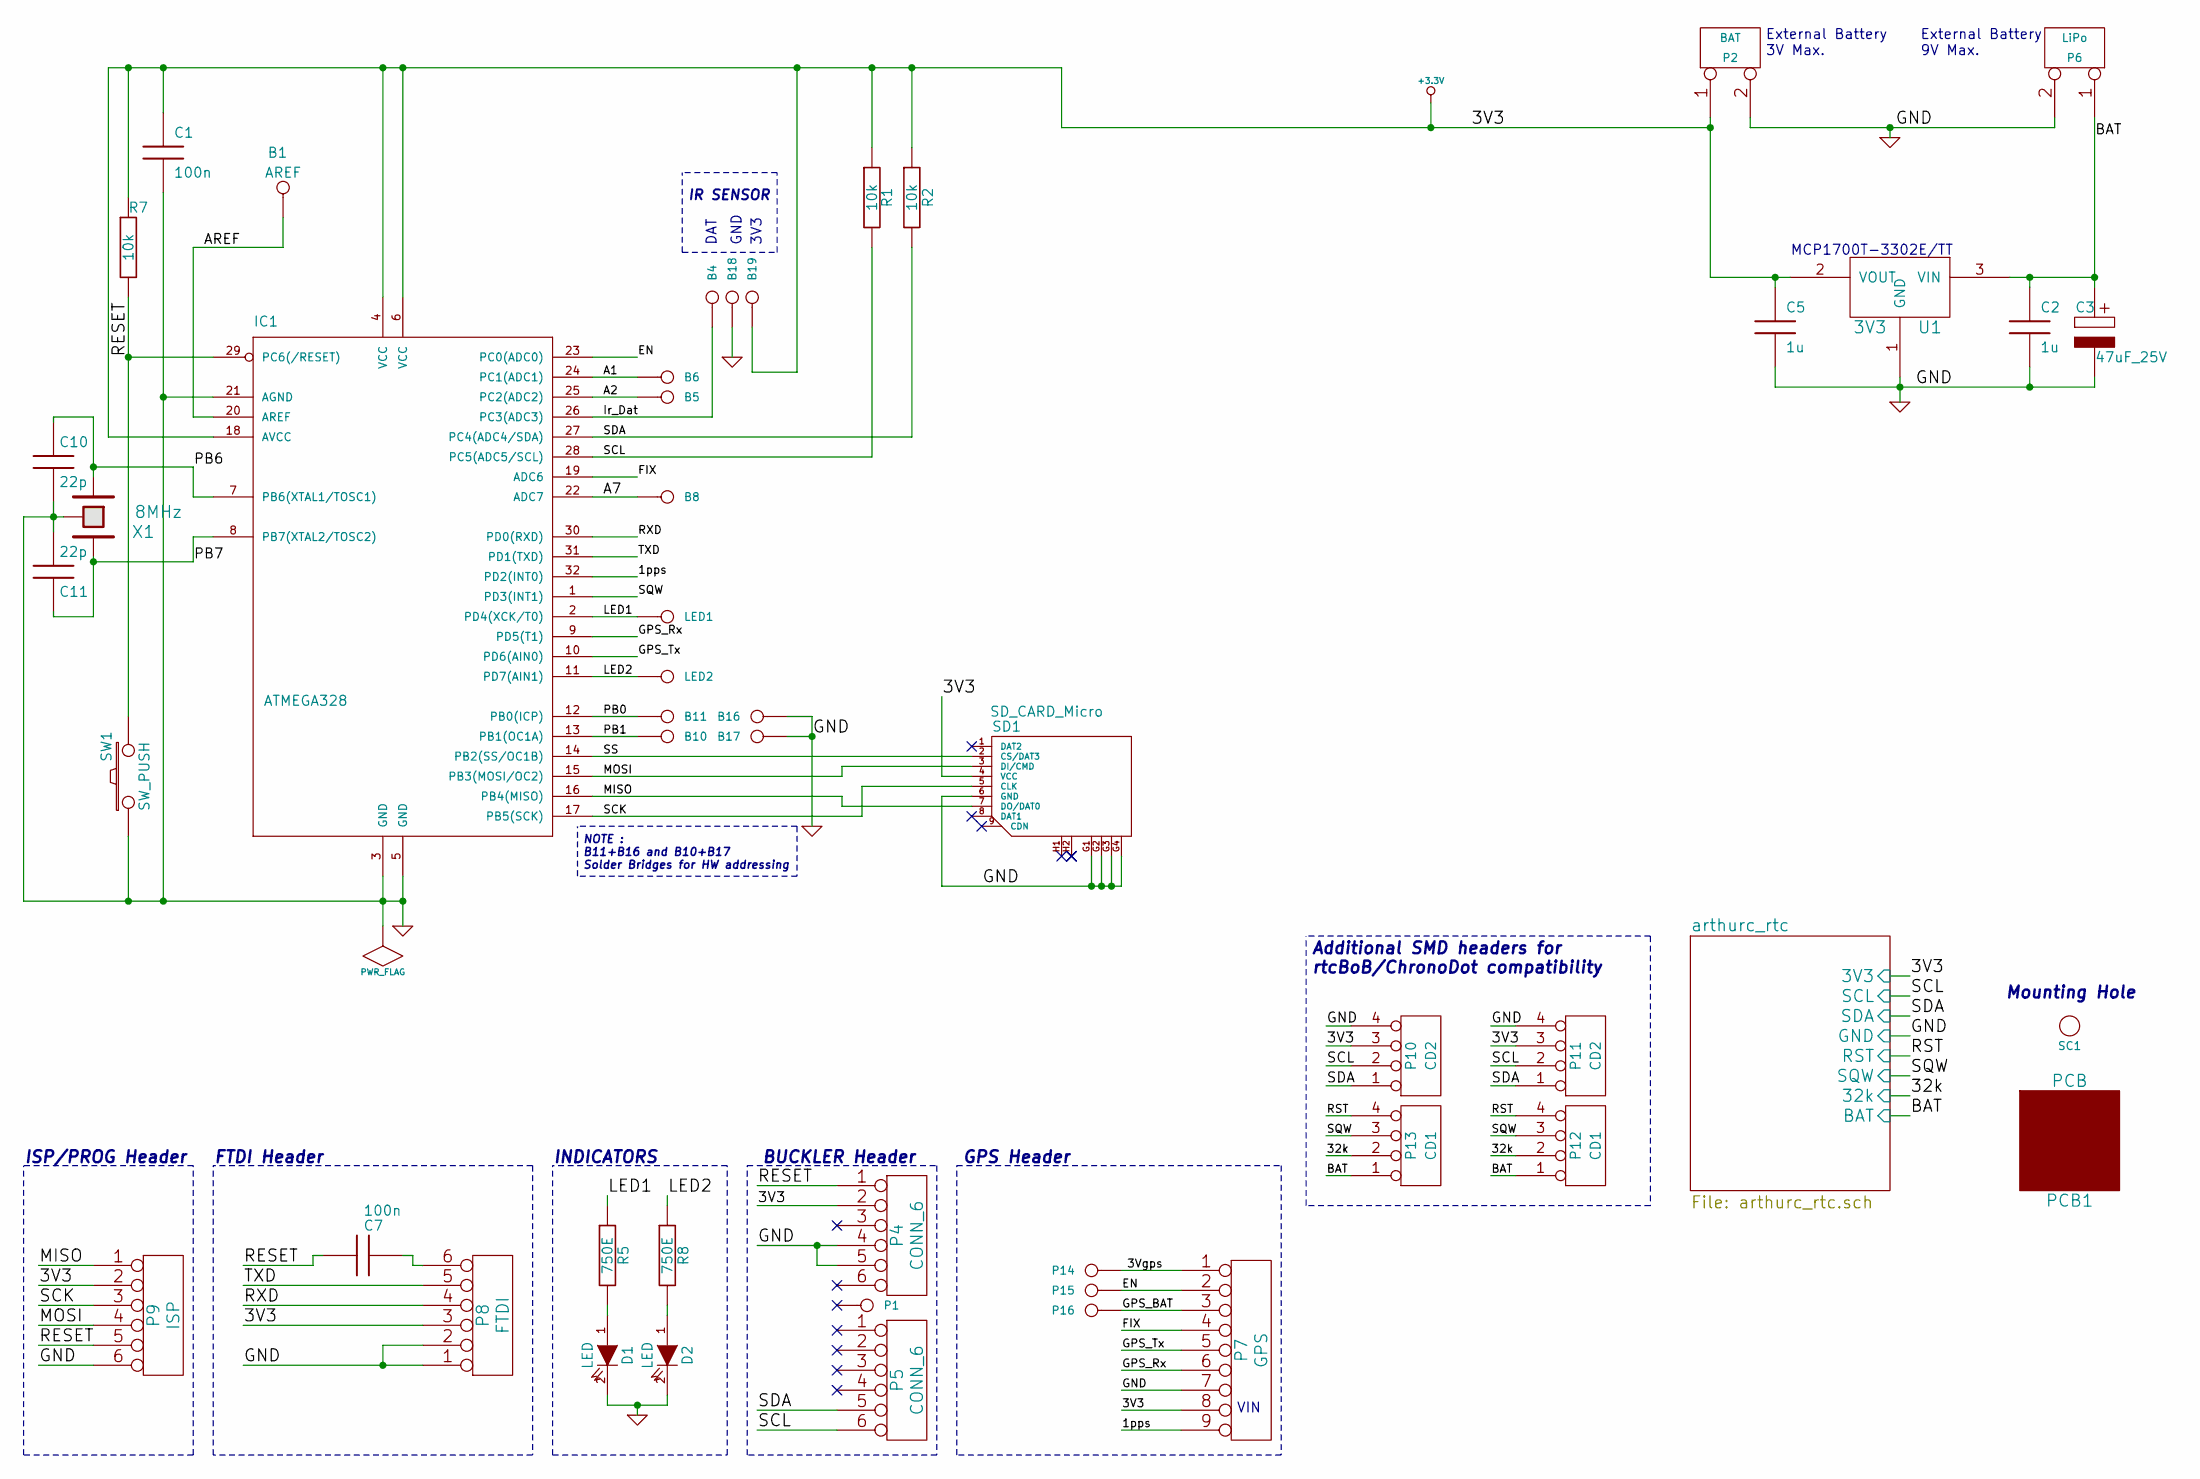
[picture p12: schematic arthurc.sch, Buckler+i2sd+RTC+HW addr+GPS+uSD+IRrx]

Parts:
B1: AREF; I%2fO
B4, B5, B6, B8, B18, B19: I/O; I%2fO
B10, B11, B16, B17: I/O; I%2fO_ADR
C1, C7: 100n; c_0805
C2, C5: 1u; c_0805
C3: 47uF_25V; C_ELCO_SMD
C10, C11: 22p; c_0805; Digikey 490-1734-1-ND
D1, D2: LED; d_0805
IC1: ATMEGA328; TQFP32
LED1, LED2: I/O; I%2fO
P1, P14, P15, P16: I/O; I%2fO
P2: BAT; pin_strip_2
P4, P5: CONN_6; PIN_ARRAY-6X1
P6: LiPo; pin_strip_2
P7: GPS; PIN_ARRAY-9X1
P8: FTDI; PIN_ARRAY-6X1
P9: ISP
P10, P11: CD2; Sck-04-F-SMT
P12, P13: CD1; Sck-04-F-SMT
PCB1: PCB
R1, R2, R7: 10k; r_0805
R5, R8: 750E; r_0805
SC1: SCREW; vite_3mm
SD1: SD_CARD_Micro; SD_Micro
SW1: SW_PUSH; SW_SMD
U1: 3V3; SOT23-3; Part No MCP1700T-3302E/TT
X1: 8MHz; Xtal_SMD4

Connections:
+3.3V: B19.1, C1.1, C5.1, IC1.4 (VCC), IC1.6 (VCC), IC1.18 (AVCC), P2.1, P4.2, P7.8, P8.3, P9.2, P10.3, P11.3, R1.1, R2.1, R7.1, SD1.4 (VCC), U1.2 (VOUT); also elsewhere on the board
/1pps: IC1.32 (PD2(INT0)), P7.9
/3Vgps: P7.1, P14.1
/A1: B6.1, IC1.24 (PC1(ADC1))
/A2: B5.1, IC1.25 (PC2(ADC2))
/A7: B8.1, IC1.22 (ADC7)
/AREF: B1.1, IC1.20 (AREF)
/EN: IC1.23 (PC0(ADC0)), P7.2, P15.1
/FIX: IC1.19 (ADC6), P7.4
/GPS_BAT: P7.3, P16.1
/GPS_Rx: IC1.9 (PD5(T1)), P7.6
/GPS_Tx: IC1.10 (PD6(AIN0)), P7.5
/Ir_Dat: B4.1, IC1.26 (PC3(ADC3))
/LED1: IC1.2 (PD4(XCK/T0)), LED1.1, R5.1
/LED2: IC1.11 (PD7(AIN1)), LED2.1, R8.1
/MISO: IC1.16 (PB4(MISO)), P9.1, SD1.7 (DO/DAT0)
/MOSI: IC1.15 (PB3(MOSI/OC2)), P9.4, SD1.3 (DI/CMD)
/PB0: B11.1, IC1.12 (PB0(ICP))
/PB1: B10.1, IC1.13 (PB1(OC1A))
/PB6: C10.1, IC1.7 (PB6(XTAL1/TOSC1)), X1.1
/PB7: C11.2, IC1.8 (PB7(XTAL2/TOSC2)), X1.2
/RESET: C7.2, IC1.29 (PC6(/RESET)), P4.1, P9.5, R7.2, SW1.2
/RXD: IC1.30 (PD0(RXD)), P8.4
/SCK: IC1.17 (PB5(SCK)), P9.3, SD1.5 (CLK)
/SS: IC1.14 (PB2(SS/OC1B)), SD1.2 (CS/DAT3)
/TXD: IC1.31 (PD1(TXD)), P8.5
/arthurc_rtc/32k: P12.2, P13.2; also elsewhere on the board
/arthurc_rtc/BAT: C2.1, C3.1, P6.1, P12.1, P13.1, U1.3 (VIN); also elsewhere on the board
/arthurc_rtc/RST: P12.4, P13.4; also elsewhere on the board
/arthurc_rtc/SCL: IC1.28 (PC5(ADC5/SCL)), P5.6, P10.2, P11.2, R1.2; also elsewhere on the board
/arthurc_rtc/SDA: IC1.27 (PC4(ADC4/SDA)), P5.5, P10.1, P11.1, R2.2; also elsewhere on the board
/arthurc_rtc/SQW: IC1.1 (PD3(INT1)), P12.3, P13.3; also elsewhere on the board
GND: B16.1, B17.1, B18.1, C1.2, C2.2, C3.2, C5.2, C10.2, C11.1, D1.2 (K), D2.2 (K), IC1.3 (GND), IC1.5 (GND), IC1.21 (AGND), P2.2 (PM), P4.4, P4.5, P6.2 (PM), P7.7, P8.1, P8.2, P9.6, P10.4, P11.4, SD1.6 (GND), SD1.G1, SD1.G2, SD1.G3, SD1.G4, SW1.1, U1.1 (GND), X1.3; also elsewhere on the board
unnamed: C7.1, P8.6
unnamed: D1.1 (A), R5.2
unnamed: D2.1 (A), R8.2

Notes on the sheet:
MCP1700T-3302E/TT
GPS Header
3V3
GND
DAT
IR SENSOR
NOTE : B11+B16 and B10+B17 Solder Bridges for HW addressing
External Battery 9V Max.
INDICATORS
FTDI Header
ISP/PROG Header
BUCKLER Header
Mounting Hole
Additional SMD headers for rtcBoB/ChronoDot compatibility
VIN
External Battery 3V Max.

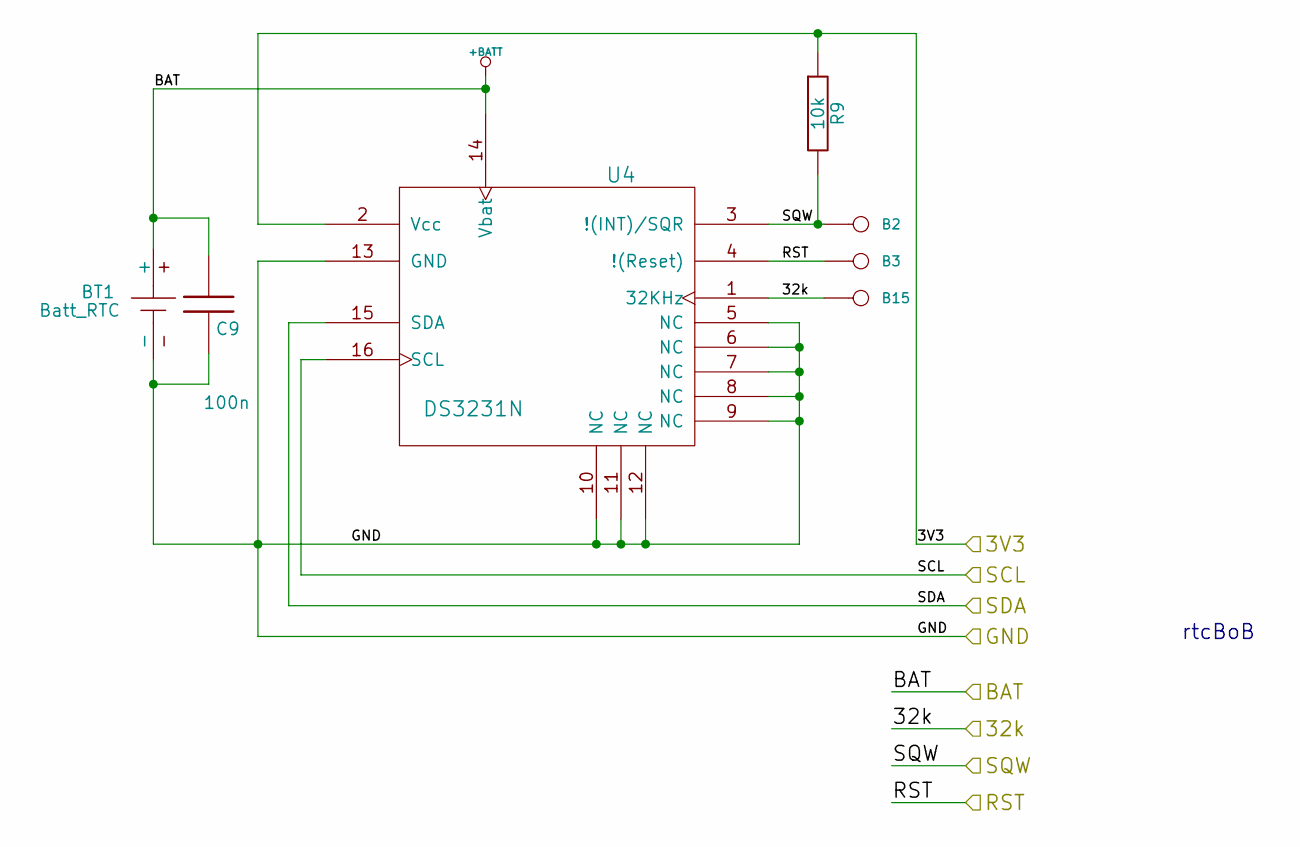
[picture p13: schematic arthurc_rtc.sch, Buckler, i2sd, v3, with RTC, with HW addressing]

Parts:
B2, B3, B15: I/O; I%2fO
BT1: Batt_RTC; CR1632; Digikey BU2032SM-HD-GCT-ND
C9: 100n; c_0805
R9: 10k; r_0805
U4: DS3231N; DS3231

Connections:
+3.3V: R9.1, U4.2 (Vcc); also elsewhere on the board
/arthurc_rtc/32k: B15.1, U4.1 (32KHz); also elsewhere on the board
/arthurc_rtc/BAT: BT1.+, C9.1, U4.14 (Vbat); also elsewhere on the board
/arthurc_rtc/RST: B3.1, U4.4 (!(Reset)); also elsewhere on the board
/arthurc_rtc/SCL: U4.16 (SCL); also elsewhere on the board
/arthurc_rtc/SDA: U4.15 (SDA); also elsewhere on the board
/arthurc_rtc/SQW: B2.1, R9.2, U4.3 (!(INT)/SQR); also elsewhere on the board
GND: BT1.-, C9.2, U4.5 (NC), U4.6 (NC), U4.7 (NC), U4.8 (NC), U4.9 (NC), U4.10 (NC), U4.11 (NC), U4.12 (NC), U4.13 (GND); also elsewhere on the board

Notes on the sheet:
rtcBoB

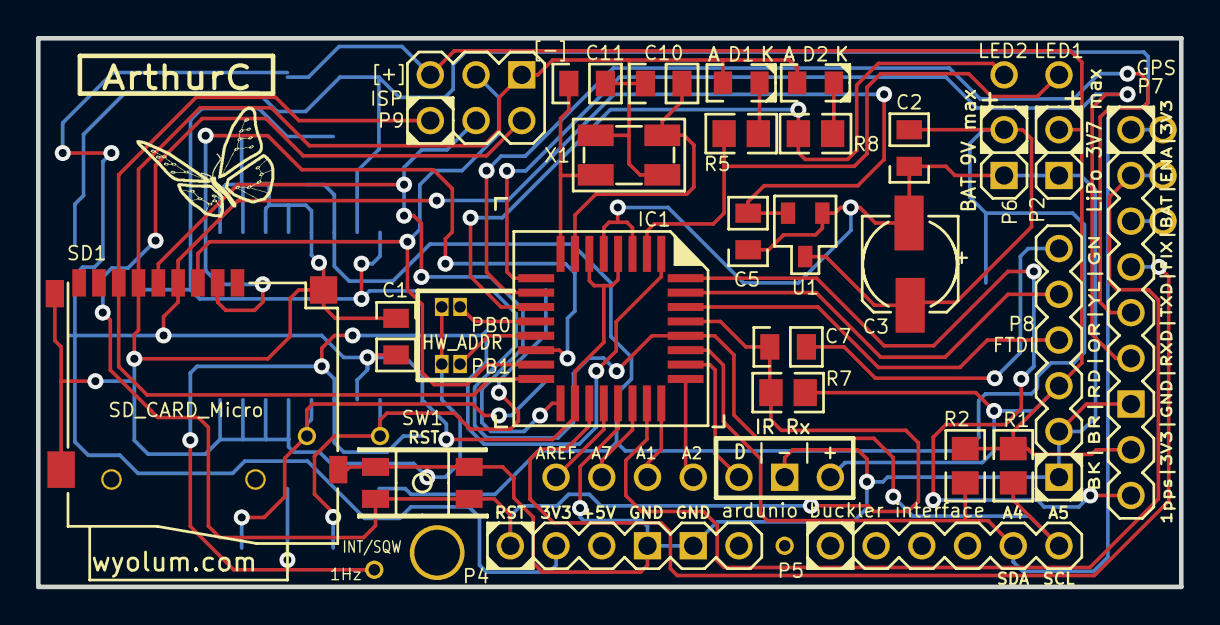
[picture p14: board arthurc.kicad_pcb from above]

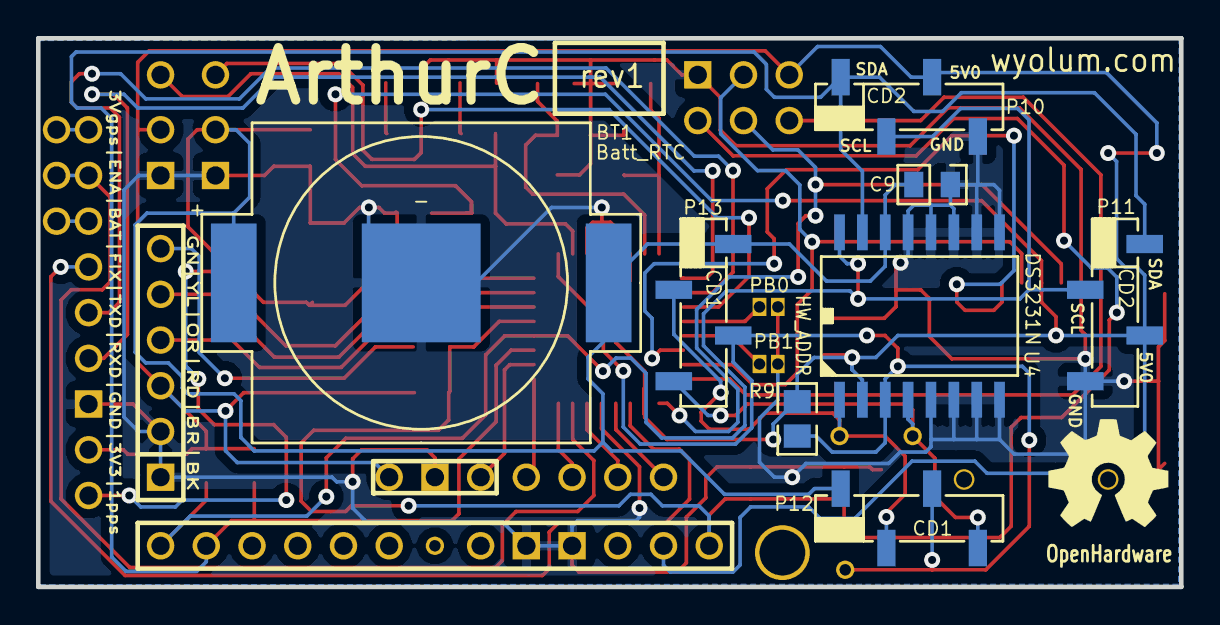
[picture p15: board arthurc.kicad_pcb from below]

Board: 2 copper layers, 63.5 x 30.5 mm, 57 parts (8 on the bottom side), 36 nets.

Other parts of the board:
G1: Logo-WL3
