wyolum/ArthurC/KiCAD/rev1/arthurc_rtc.sch

## KiCad design KiCAD/rev1/arthurc_rtc.sch (2014-05-08, an earlier design)


Parts:
B2, B3, B15: I/O; I%2fO
BT1: Batt_RTC; CR1632; Digikey BU2032SM-HD-GCT-ND
C9: 100n; c_0805
R9: 10k; r_0805
U4: DS3231N; DS3231

Connections:
3V3: R9.1, U4.2 (Vcc)
32k: B15.1, U4.1 (32KHz)
+BATT: BT1.+, C9.1, U4.14 (Vbat)
GND: BT1.-, C9.2, U4.5 (NC), U4.6 (NC), U4.7 (NC), U4.8 (NC), U4.9 (NC), U4.10 (NC), U4.11 (NC), U4.12 (NC), U4.13 (GND)
RST: B3.1, U4.4 (!(Reset))
SCL: U4.16 (SCL)
SDA: U4.15 (SDA)
SQW: B2.1, R9.2, U4.3 (!(INT)/SQR)

Notes on the sheet:
rtcBoB
