wyolum/ArthurC/(commit log)

2014-03-01 first commit of ArthurC - which is rev2 of i2GPS
    [GPS I2C Interface version 1.xls, arthurc.brd, arthurc.sch, arthurc_BoM.ods, arthurc_BoM_pcb.csv, arthurc_BoM_sch.csv, arthurc_BoM_seeed.ods, arthurc_rtc.sch]
2014-03-01 re-organized to wyolum standard directory structure, added gps datasheet
    [GPS I2C Interface version 1.xls, arthurc.brd, arthurc.sch, arthurc_BoM.ods, arthurc_BoM_pcb.csv, arthurc_BoM_sch.csv, arthurc_BoM_seeed.ods, arthurc_rtc.sch]
2014-03-06 ArthurC work in progress
    [arthurc.kicad_pcb, arthurc.sch, arthurc_rtc.sch]
2014-04-01 Ultimate GPS header added to I2GPS
    [arthurc.sch, arthurc_rtc.sch]
2014-04-02 work in progress
    [arthurc.kicad_pcb]
2014-04-27 work in progress, converting design to work on 3V3
    [arthurc.sch, arthurc_rtc.sch]
2014-04-29 schematic needs final review before starting board layout
    [arthurc.sch, arthurc_rtc.sch]
2014-05-07 board layout work in progress
    [arthurc.kicad_pcb, arthurc.sch]
2014-05-20 ArthurC rev1 work in progress. Added rev2 directory for USB version
    [arthurc.brd, arthurc.kicad_pcb, arthurc.sch, arthurc_BoM.ods, arthurc_BoM_pcb.csv, arthurc_BoM_sch.csv, arthurc_BoM_seeed.ods, arthurc_rtc.sch]
2014-05-22 ArthurC rev1 (FTDI ver) complete.
    [BoM_arthurc.ods, BoM_arthurc_pcb.csv, BoM_arthurc_sch.csv, BoM_arthurc_seeed.ods, arthurc.csv, arthurc.kicad_pcb, arthurc.sch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]
2014-05-24 ArthurC rev1 ready. Added LED breakout pads
    [arthurc.kicad_pcb, arthurc.sch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]
2014-05-25 ArthurC rev2 work in progress
    [arthurc.sch, arthurc_rtc.sch]
2014-05-27 breakout pads made bigger in ArthurC_rev1
    [arthurc.kicad_pcb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]
2014-05-28 final ArthurC rev1
    [arthurc.kicad_pcb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]
2014-06-26 just syncing my folders, nothing new here
    [arthurc.kicad_pcb]
